DoggySazHi/MiniHakkero.EDA/Unified/Unified.kicad_pcb

## KiCad design Unified/Unified.kicad_pcb (2026-10-15)

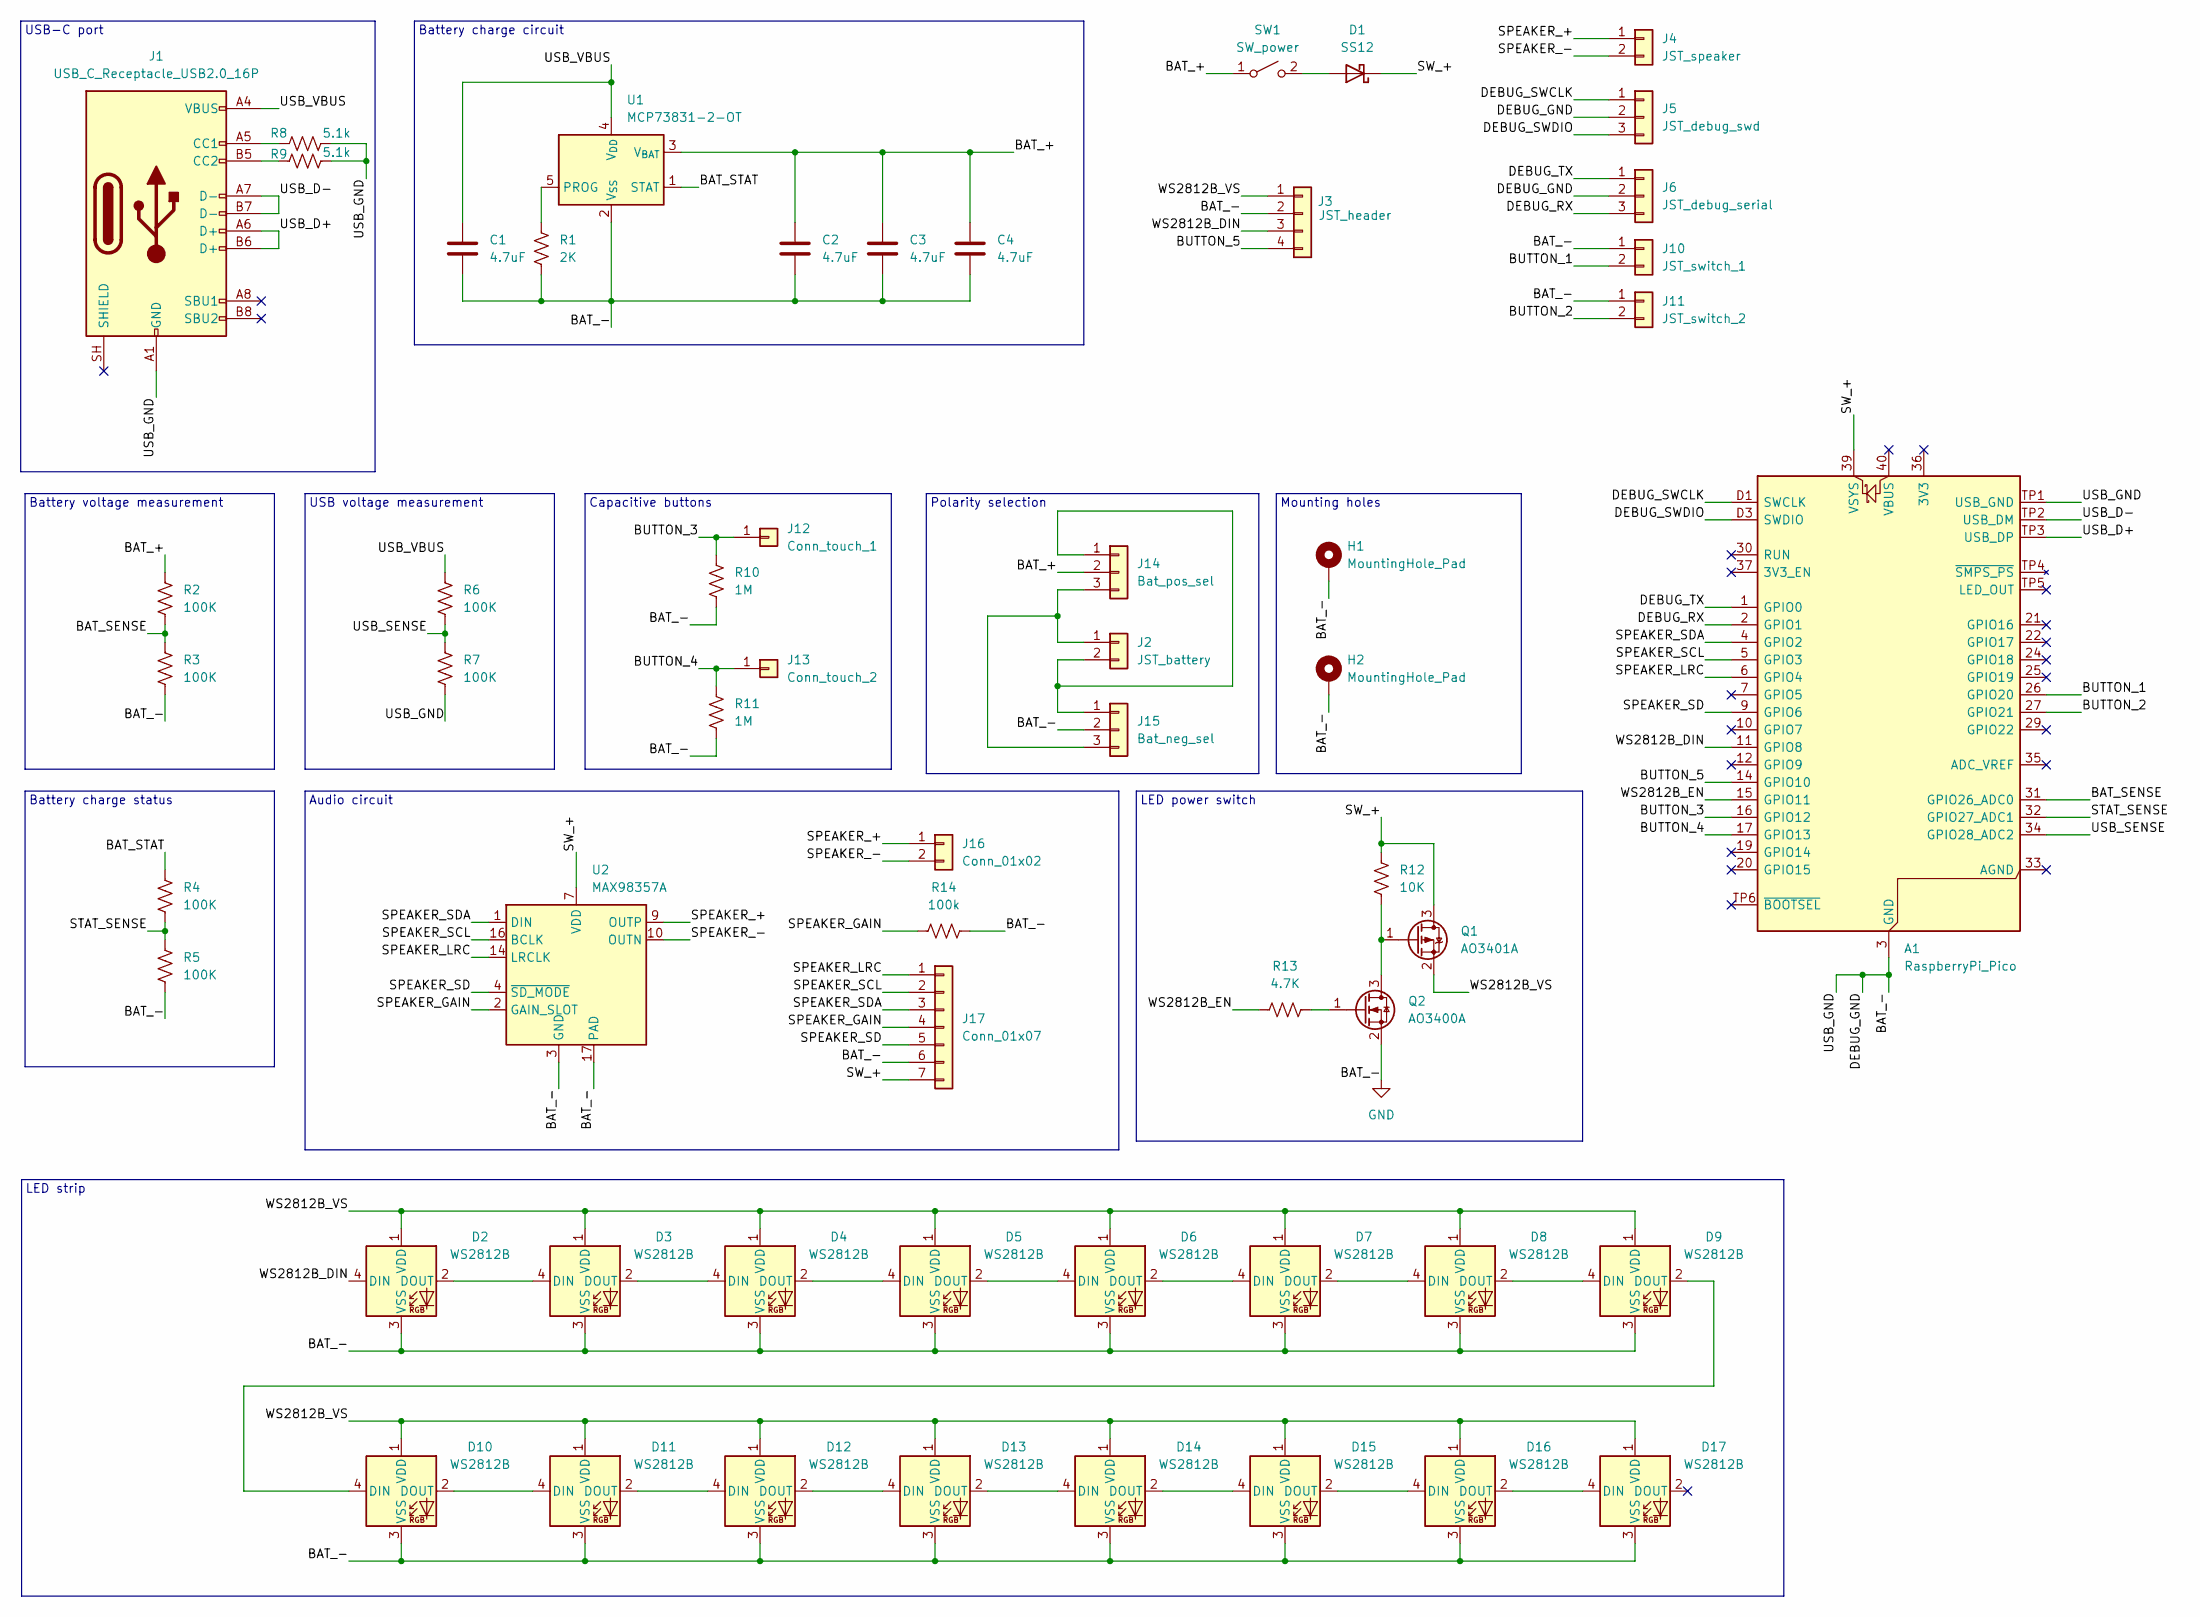
[picture p1: schematic Unified.kicad_sch]

Parts:
A1: RaspberryPi_Pico; RaspberryPi_Pico_SMD
C1, C2, C3, C4: 4.7uF; C_0603_1608Metric_Pad1.08x0.95mm_HandSolder
D1: SS12; D_SMA
D2, D3, D4, D5, D6, D7, D8, D9, D10, D11, D12, D13, D14, D15, D16, D17: WS2812B; LED_WS2812B_PLCC4_5.0x5.0mm_P3.2mm
H1, H2: MountingHole_Pad; MountingHole_2.2mm_M2_ISO7380_Pad
J1: USB_C_Receptacle_USB2.0_16P; USB_C_Receptacle_Palconn_UTC16-G
J2: JST_battery; JST_PH_B2B-PH-SM4-TB_1x02-1MP_P2.00mm_Vertical
J3: JST_header; JST_SH_BM04B-SRSS-TB_1x04-1MP_P1.00mm_Vertical
J4: JST_speaker; JST_SH_BM02B-SRSS-TB_1x02-1MP_P1.00mm_Vertical
J5: JST_debug_swd; JST_SH_BM03B-SRSS-TB_1x03-1MP_P1.00mm_Vertical
J6: JST_debug_serial; JST_SH_BM03B-SRSS-TB_1x03-1MP_P1.00mm_Vertical
J10: JST_switch_1; JST_SH_BM02B-SRSS-TB_1x02-1MP_P1.00mm_Vertical
J11: JST_switch_2; JST_SH_BM02B-SRSS-TB_1x02-1MP_P1.00mm_Vertical
J12: Conn_touch_1; PinHeader_1x01_P2.54mm_Vertical
J13: Conn_touch_2; PinHeader_1x01_P2.54mm_Vertical
J14: Bat_pos_sel; SolderJumper-3_P2.0mm_Open_TrianglePad1.0x1.5mm_NumberLabels
J15: Bat_neg_sel; SolderJumper-3_P2.0mm_Open_TrianglePad1.0x1.5mm_NumberLabels
J16: Conn_01x02; PinHeader_1x02_P2.54mm_Vertical
J17: Conn_01x07; PinSocket_1x07_P2.54mm_Vertical
Q1: AO3401A; SOT-23
Q2: AO3400A; SOT-23
R1: 2K; R_0603_1608Metric_Pad0.98x0.95mm_HandSolder
R2, R3, R4, R5, R6, R7: 100K; R_0603_1608Metric_Pad0.98x0.95mm_HandSolder
R8, R9: 5.1k; R_0603_1608Metric_Pad0.98x0.95mm_HandSolder
R10, R11: 1M; R_0603_1608Metric_Pad0.98x0.95mm_HandSolder
R12: 10K; R_0603_1608Metric_Pad0.98x0.95mm_HandSolder
R13: 4.7K; R_0603_1608Metric_Pad0.98x0.95mm_HandSolder
R14: 100k; R_0603_1608Metric_Pad0.98x0.95mm_HandSolder
SW1: SW_power; JST_SH_BM02B-SRSS-TB_1x02-1MP_P1.00mm_Vertical
U1: MCP73831-2-OT; SOT-23-5
U2: MAX98357A; TQFN-16-1EP_3x3mm_P0.5mm_EP1.23x1.23mm

Connections:
/BAT_+: C2.2, C3.2, C4.2, J14.2, R2.1, SW1.1 (A), U1.3 (V_{BAT})
/BAT_SENSE: A1.31 (GPIO26_ADC0), R2.2, R3.1
/BAT_STAT: R4.1, U1.1 (STAT)
/BUTTON_1: A1.26 (GPIO20), J10.2
/BUTTON_2: A1.27 (GPIO21), J11.2
/BUTTON_3: A1.16 (GPIO12), J12.1 (Pin_1_1), R10.1
/BUTTON_4: A1.17 (GPIO13), J13.1 (Pin_1_1), R11.1
/BUTTON_5: A1.14 (GPIO10), J3.4
/DEBUG_RX: A1.2 (GPIO1), J6.3
/DEBUG_SWCLK: A1.D1 (SWCLK), J5.1
/DEBUG_SWDIO: A1.D3 (SWDIO), J5.3
/DEBUG_TX: A1.1 (GPIO0), J6.1
/SPEAKER_+: J4.1, J16.1, U2.9 (OUTP)
/SPEAKER_-: J4.2, J16.2, U2.10 (OUTN)
/SPEAKER_GAIN: J17.4, R14.1, U2.2 (GAIN_SLOT)
/SPEAKER_LRC: A1.6 (GPIO4), J17.1, U2.14 (LRCLK)
/SPEAKER_SCL: A1.5 (GPIO3), J17.2, U2.16 (BCLK)
/SPEAKER_SD: A1.9 (GPIO6), J17.5, U2.4 (~SD_MODE)
/SPEAKER_SDA: A1.4 (GPIO2), J17.3, U2.1 (DIN)
/STAT_SENSE: A1.32 (GPIO27_ADC1), R4.2, R5.1
/SW_+: A1.39 (VSYS), D1.1 (K), J17.7, Q1.3 (D), R12.1, U2.7 (VDD), U2.8 (VDD)
/USB_D+: A1.TP3 (USB_DP), J1.A6 (D+), J1.B6 (D+)
/USB_D-: A1.TP2 (USB_DM), J1.A7 (D-), J1.B7 (D-)
/USB_SENSE: A1.34 (GPIO28_ADC2), R6.2, R7.1
/USB_VBUS: C1.2, J1.A4 (VBUS), J1.A9 (VBUS), J1.B4 (VBUS), J1.B9 (VBUS), R6.1, U1.4 (V_{DD})
/WS2812B_DIN: A1.11 (GPIO8), D2.4 (DIN), J3.3
/WS2812B_EN: A1.15 (GPIO11), R13.1
/WS2812B_VS: D2.1 (VDD), D3.1 (VDD), D4.1 (VDD), D5.1 (VDD), D6.1 (VDD), D7.1 (VDD), D8.1 (VDD), D9.1 (VDD), D10.1 (VDD), D11.1 (VDD), D12.1 (VDD), D13.1 (VDD), D14.1 (VDD), D15.1 (VDD), D16.1 (VDD), D17.1 (VDD), J3.1, Q1.2 (S)
GND: A1.3 (GND), A1.8 (GND), A1.13 (GND), A1.18 (GND), A1.23 (GND), A1.28 (GND), A1.38 (GND), A1.D2 (GND), A1.TP1 (USB_GND), C1.1, C2.1, C3.1, C4.1, D2.3 (VSS), D3.3 (VSS), D4.3 (VSS), D5.3 (VSS), D6.3 (VSS), D7.3 (VSS), D8.3 (VSS), D9.3 (VSS), D10.3 (VSS), D11.3 (VSS), D12.3 (VSS), D13.3 (VSS), D14.3 (VSS), D15.3 (VSS), D16.3 (VSS), D17.3 (VSS), H1.1 (1_1), H2.1 (1_1), J1.A1 (GND), J1.A12 (GND), J1.B1 (GND), J1.B12 (GND), J3.2, J5.2, J6.2, J10.1, J11.1, J15.2, J17.6, Q2.2 (S), R1.2, R3.2, R5.2, R7.2, R8.2, R9.2, R10.2, R11.2, R14.2, U1.2 (V_{SS}), U2.3 (GND), U2.11 (GND), U2.15 (GND), U2.17 (PAD)
unnamed: D1.2 (A), SW1.2 (B)
unnamed: D2.2 (DOUT), D3.4 (DIN)
unnamed: D3.2 (DOUT), D4.4 (DIN)
unnamed: D4.2 (DOUT), D5.4 (DIN)
unnamed: D5.2 (DOUT), D6.4 (DIN)
unnamed: D6.2 (DOUT), D7.4 (DIN)
unnamed: D7.2 (DOUT), D8.4 (DIN)
unnamed: D8.2 (DOUT), D9.4 (DIN)
unnamed: D9.2 (DOUT), D10.4 (DIN)
unnamed: D10.2 (DOUT), D11.4 (DIN)
unnamed: D11.2 (DOUT), D12.4 (DIN)
unnamed: D12.2 (DOUT), D13.4 (DIN)
unnamed: D13.2 (DOUT), D14.4 (DIN)
unnamed: D14.2 (DOUT), D15.4 (DIN)
unnamed: D15.2 (DOUT), D16.4 (DIN)
unnamed: D16.2 (DOUT), D17.4 (DIN)
unnamed: J1.A5 (CC1), R8.1
unnamed: J1.B5 (CC2), R9.1
unnamed: J2.2, J14.1, J15.1
unnamed: J2.1, J14.3, J15.3
unnamed: Q1.1 (G), Q2.3 (D), R12.2
unnamed: Q2.1 (G), R13.2
unnamed: R1.1, U1.5 (PROG)

Notes on the sheet:
Battery voltage measurement
USB voltage measurement
USB-C port
Polarity selection
LED strip
Mounting holes
Battery charge circuit
Audio circuit
Capacitive buttons
LED power switch
Battery charge status

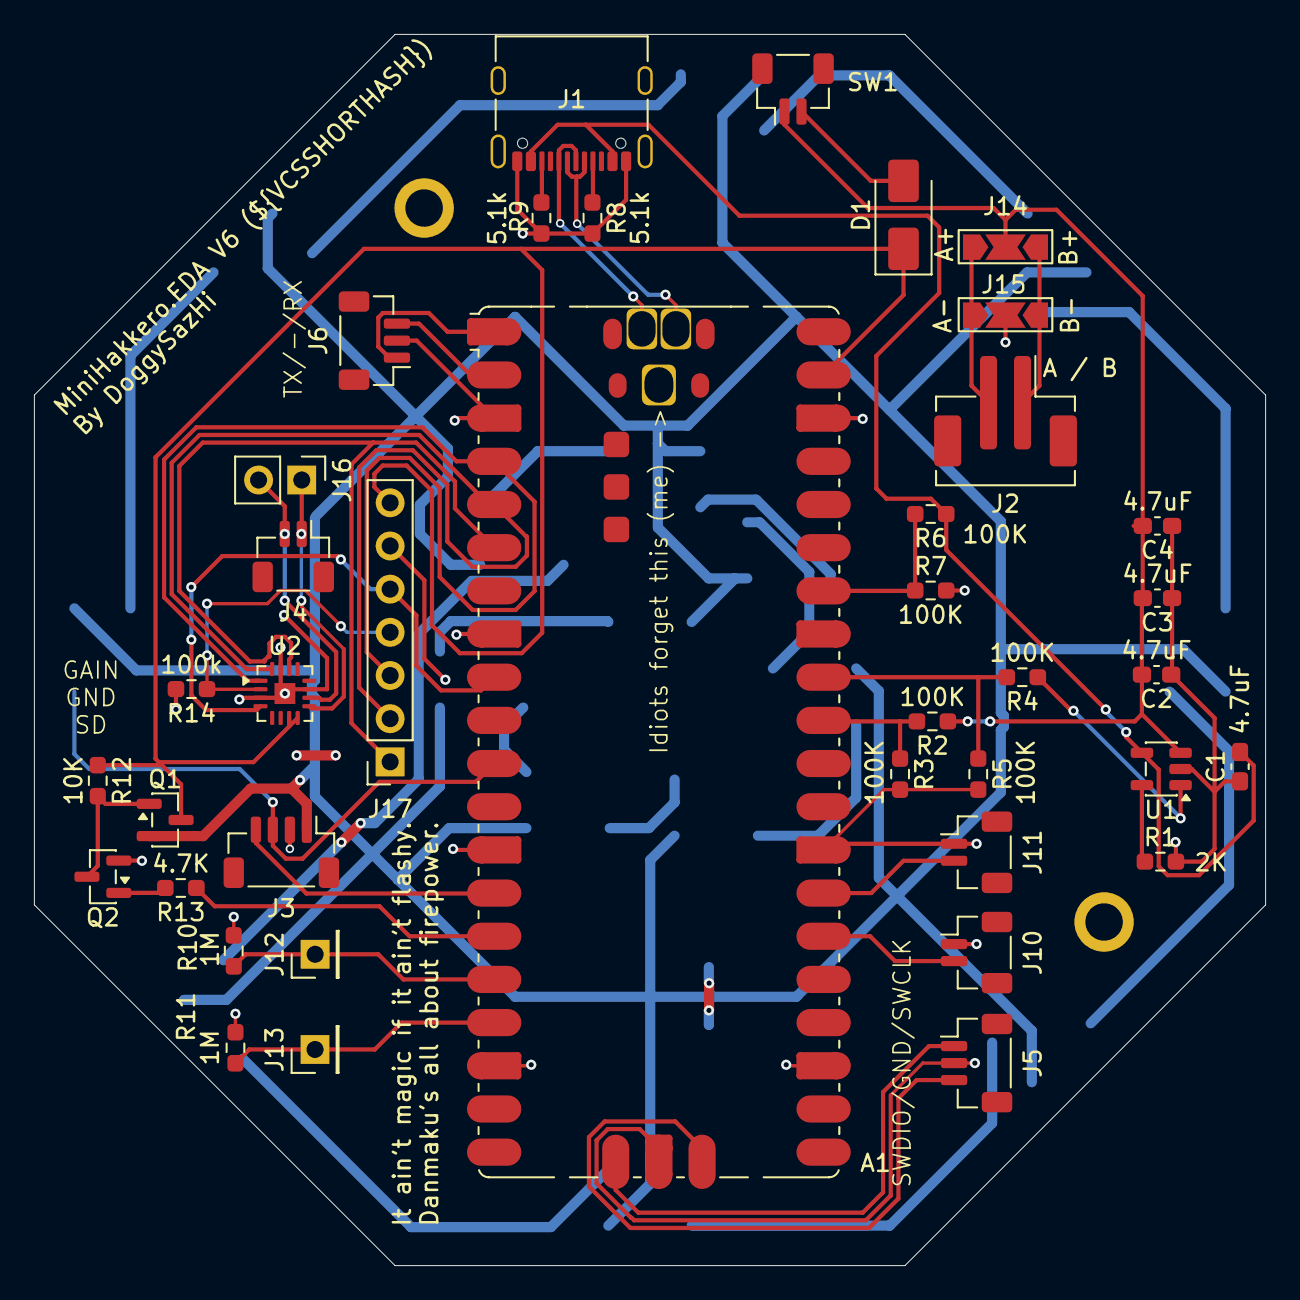
[picture p2: board Unified.kicad_pcb from above]

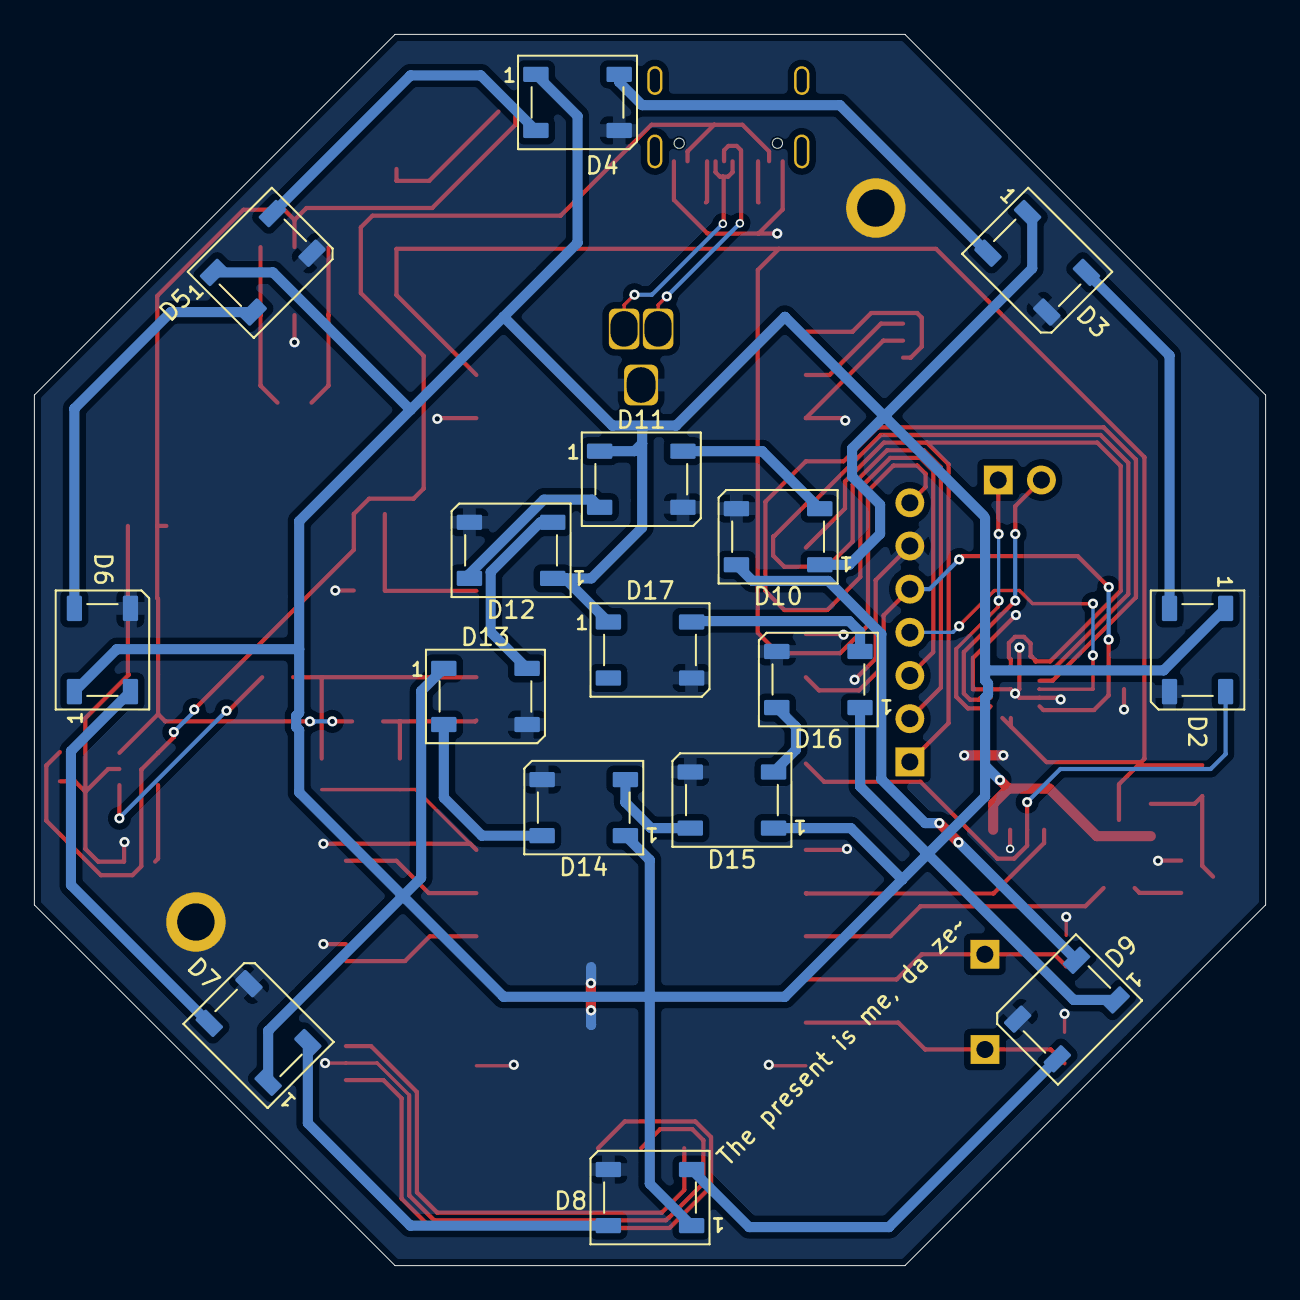
[picture p3: board Unified.kicad_pcb from below]

Board: 2 copper layers, 72.4 x 72.4 mm, 57 parts (16 on the bottom side), 52 nets.
