DoggySazHi/MiniHakkero.EDA/(commit log)

2026-08-03 Add LED files, finish base and LED schematics
    [Base.kicad_pcb, Base.kicad_sch, LED.kicad_pcb, LED.kicad_sch]
2026-08-04 Start work on PCBs, add CC resistors for USB charging
    [Base.kicad_pcb, Base.kicad_sch, LED.kicad_pcb]
2026-08-04 Finish LED PCB
    [LED.kicad_pcb]
2026-08-04 Almost finished routing the base PCB except USB
    [Base.kicad_pcb, Base.kicad_sch]
2026-08-04 Finish PCB routing
    [Base.kicad_pcb]
2026-08-04 Test exporting to Gerber
    [LED.kicad_pcb]
2026-08-04 Update after DRC checks, add extra switches for mini hakkero
    [Base.kicad_pcb, Base.kicad_sch, LED.kicad_pcb]
2026-08-05 Add touch pads for GPIO
    [Base.kicad_pcb, Base.kicad_sch]
2026-08-05 Export to Gerber saved settings
    [Base.kicad_pcb]
2026-09-02 Color base PCB
    [Base.kicad_pcb]
2026-09-02 Change switch to JST, fix polarity of battery connector, add power transistors for better LED off capability
    [Base.kicad_pcb, Base.kicad_sch]
2026-09-14 Add polarity solder jumpers for batteries that come in RNG polarity
    [Base.kicad_pcb, Base.kicad_sch]
2026-09-30 Work on unified PCB
    [Unified.kicad_pcb, Unified.kicad_sch]
2026-09-30 Add LEDs to unified PCB, currently routing
    [Unified.kicad_pcb, Unified.kicad_sch]
2026-10-01 Try to route but Kicad decided to crash
    [Unified.kicad_pcb]
2026-10-01 Finish main routing, plan to add other pinouts/mounting
    [Unified.kicad_pcb]
2026-10-02 Re-arrange for pin header for speaker
    [Unified.kicad_pcb, Unified.kicad_sch]
2026-10-02 Finalize routing, bump to V5
    [Unified.kicad_pcb, Unified.kicad_sch]
2026-10-02 Remove unused Base/LED projects
    [Base.kicad_pcb, Base.kicad_sch, LED.kicad_pcb, LED.kicad_sch]
2026-10-11 Add 100k resistor for defaulting audio chip gain to 15dB
2026-10-15 Add ground connection for MAX98357 pad, rewire GAIN and SD pins for header breakout, curse all actual EE nerds
